arbupo/ESP32-Internet-Radio/schematics/Schéma 1.2.pdf

,rr:

### AO -:;;, -:r::oi r

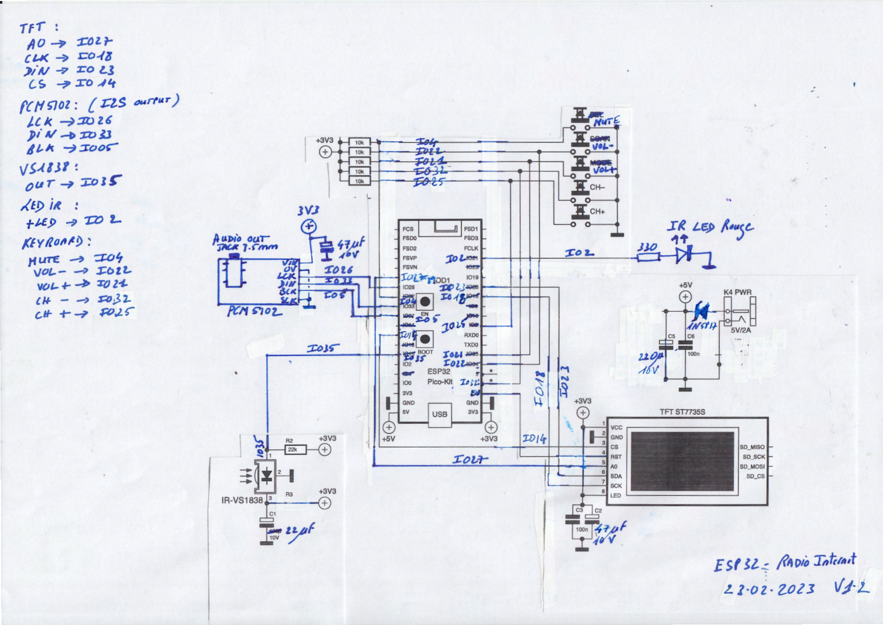
[picture p2: page 1]

CU< -> CO./Z ,,.A/ -7 XO l.l

### l~ .ro A't

f{ M Ç]Ol : { ~z.s ourfur)

J.t J< :IV Z 6
J/ A/ -1> :z:t>j)
41, I< ::roo~

### VSAIJ1:

ouT -::Colr
,<EJ> Ïll
tUJ> -Z::O L
KEY/lOlfl!>
tf uTE -=r:.o',
\JO/.. - -> j;O t Z..
VO 1.- +- X() Z-1-
l l+ - -> ~J,
e,H- +- | ~.}_$
. | L
JV.J

~ &li'"~
0 0--'-'-

.x. .,. f--
,....

'1/04
f--
CH-
Au1>10 o<Jr r,,ur7.nnm | :~~ol bd 1::~;r 1111 | - - | .J. | {~ t.1;.p '"jl-- Fso2 | FCLK | _. | ~JO
FSVP | ;ro l,.ttffl | >-0 Z..
- 1

# z.cH+

1"1001 1019

if Jj::~1 -+-1 +----41--+-1-1 1

:1,01-f-1 1

RXDO
::&oJ, | 11 | TXDO

# 1 't !f ,TT ~~~~ t-- ---1----'I 1

- ESP32
Pico-Kit

Il-.
c:i
\..\.

+3V3 1 'U) I ,,

,.,

l~

vcc

GND
CS
:COI.il- | 1¹ | .1 1 | 1 'I •I RST

,:. ttbf ...wiov

SDA
SCK
LED

T,'oo~ r,11f
~ ~vv

+SV

TFT ST7735S

SD

_

MISO
SD

_

SCK
SD

_

MOSI
SD

_

CS

## ESf ~l .::: /?APIO 1i,li1A,t

L. 1 ·0 Z · ZOl :J V,l· L
