arbupo/ESP32-Internet-Radio/schematics/Schéma.pdf

## rrr:

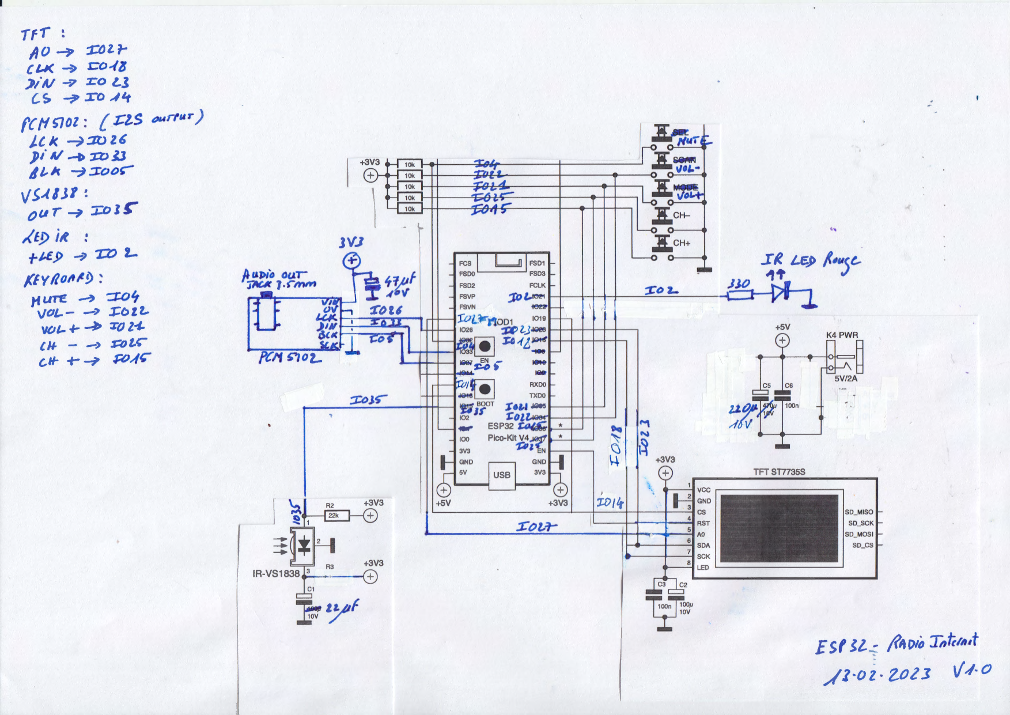
[picture p3: page 1]

### A o _,. -:r::o z. r

c U<. -> ro.,fi
;>iA/ -7 ro l.l
l> -:;, .ro A"t
f( f( ',]OZ : { ~Z.S ""'rfur) J.tJ<.
pi A/ -1> :rt> .il
41,1< 7 ::rooç-
VSA I JI:
ouT Iol r
,<EJ;> ilf :
t-UJ> -J -W 2-
KEY/lolfl!)
tf uTE -:::r:c',
vot..- -> ,1;otz ..
VCJ l- +- I() l-1-
l l+ - -> ~z.ç
e,ir +-~ ~Aç

/+.&&1>10 our
1ltUt1,f"mM

fCl'f S"IO

JV.J

1-

'r1f!f 1 ,IP'I/

CH-

## z.cH+

FCS I | lb....!] IFSD1
FSD0 | FSD3
FSD2 | FCLK
FSVP | .:f0 L,~ | :roz..
VN | 1er:!' | 1, '
=;:-51001 | 1019 if 11::1-11 l-+-1--+-I +-+I 1-+I-----,

RXDO

::t:t>J~ | ; 111 | 1 Wjj°T
1 | 102 | ESP32,

,:_,, ttbf

~OV

- Pico-Kit

°" ,...,

~ | '
CJ H \..+ | +3V3
1 | 1 | 1w,,,1 1 · 1 'j:;: :J:Olit- | 1 | . | RST +SV | +3V3

## Too~ooµ

~

.OV

# .It t..E.p ,,,,t,, 11'

+SV

TFTST7735S

SD_MISO
SD

_

SCK

SD_CS

### E Sf ~l.; ;?11010 r,,fi,,,,t

~]-OZ · ZOl 3 \/-1· 0
