arbupo/ESP32-Internet-Radio/images/221667.jpg

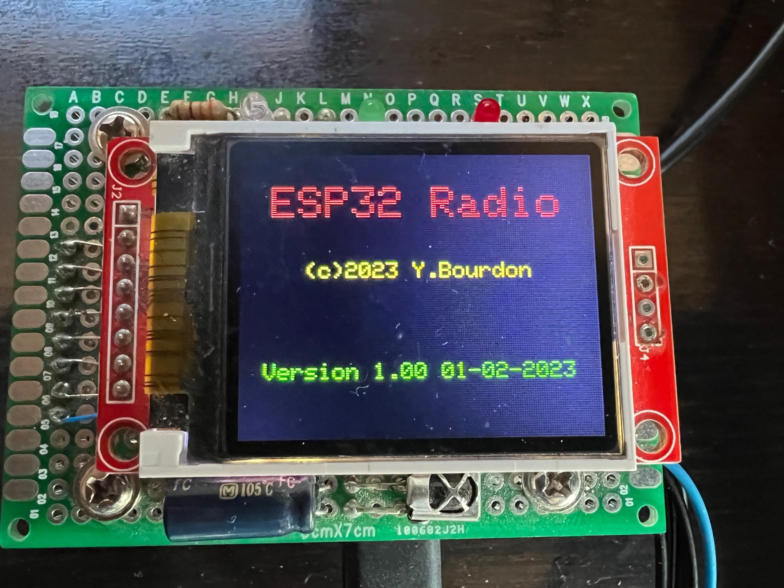
images/221667.jpg
