arbupo/ESP32-Internet-Radio/images/221671.jpg

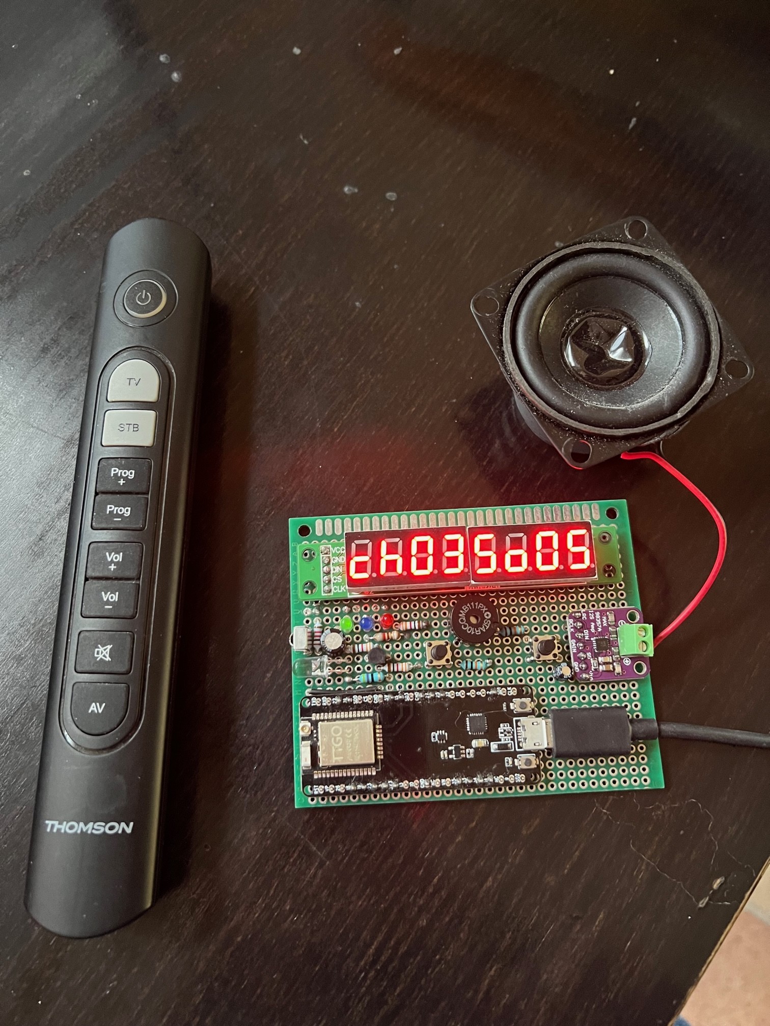
images/221671.jpg
