arbupo/ESP32-Internet-Radio/images/221672.jpg

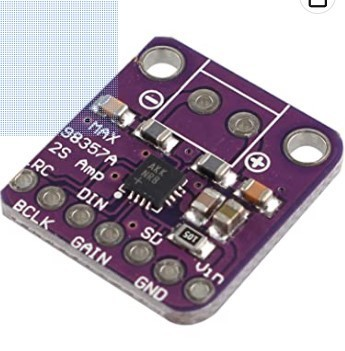
images/221672.jpg
