arbupo/ESP32-Internet-Radio/images/221673.jpg

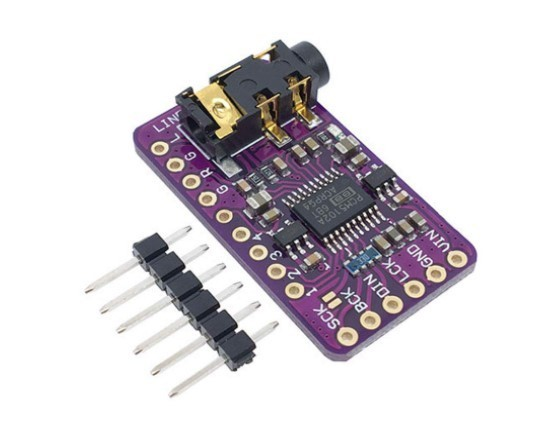
images/221673.jpg
