arbupo/ESP32-Internet-Radio/images/221978.jpg

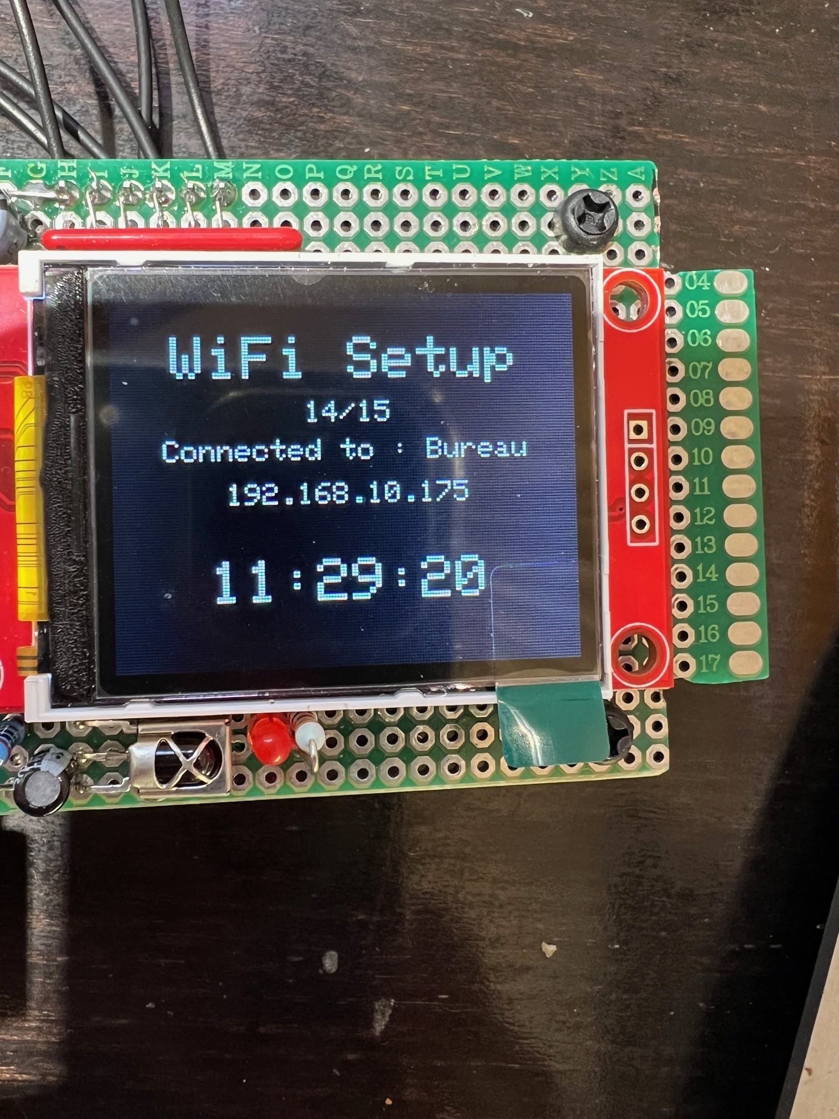
images/221978.jpg
