arbupo/ESP32-Internet-Radio/images/221979.jpg

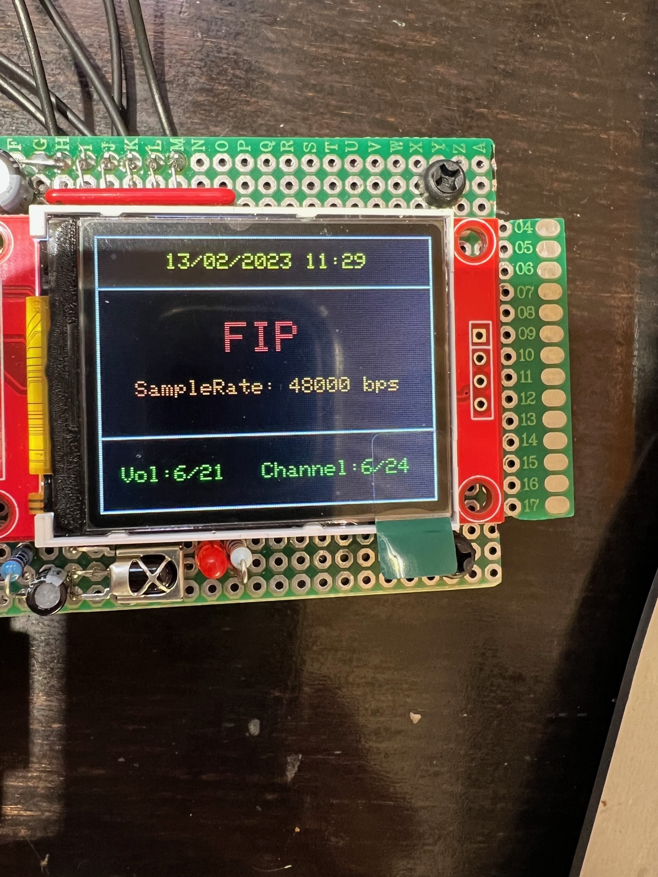
images/221979.jpg
