arbupo/ESP32-Internet-Radio/images/221980.jpg

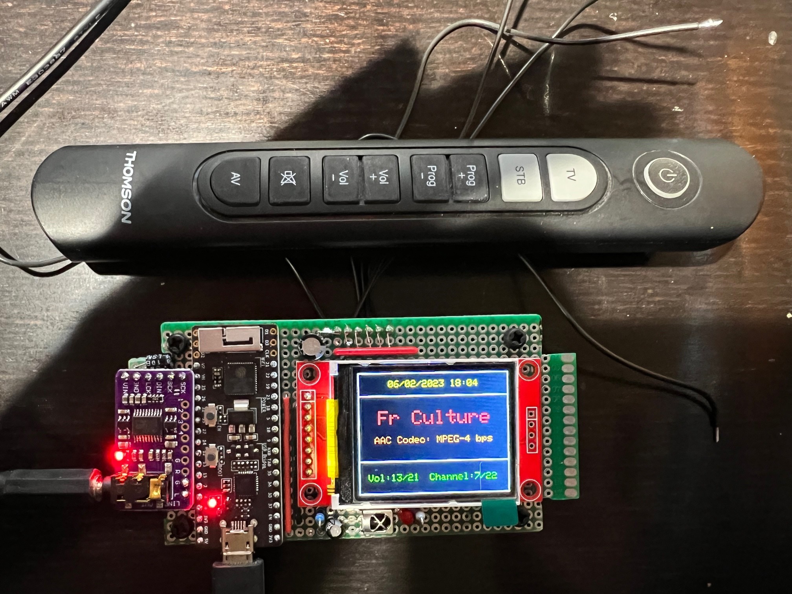
images/221980.jpg
