arbupo/ESP32-Internet-Radio/images/222188.jpg

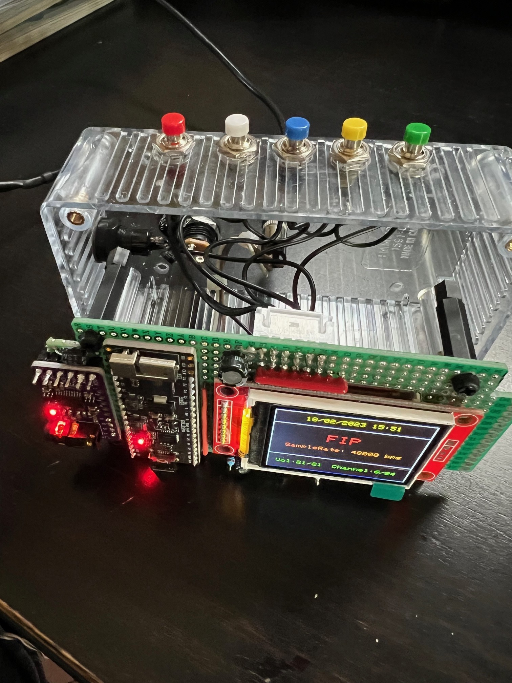
images/222188.jpg
