arbupo/ESP32-Internet-Radio/images/222189.jpg

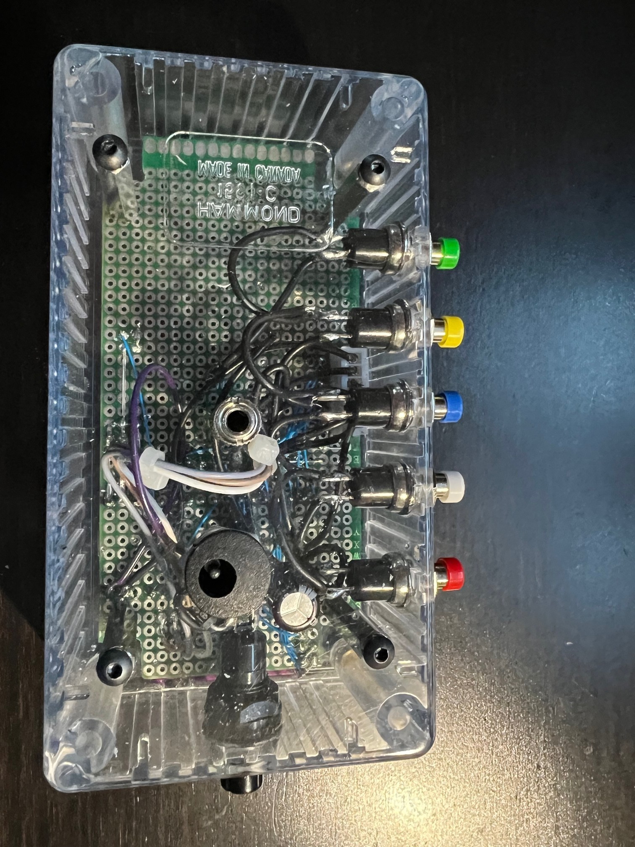
images/222189.jpg
