arbupo/ESP32-Internet-Radio/images/222190.jpg

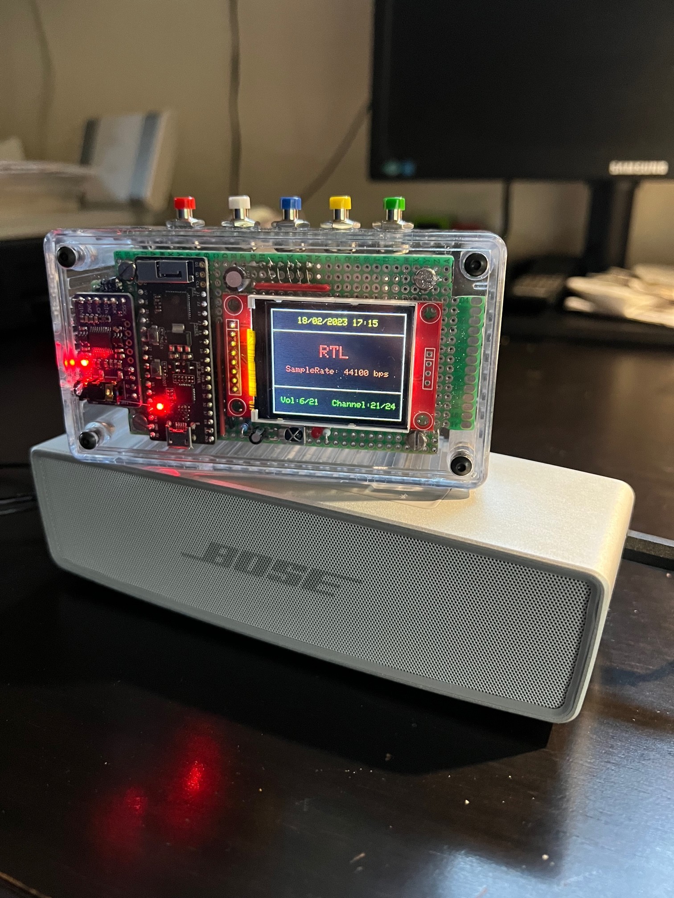
images/222190.jpg
