arbupo/ESP32-Internet-Radio/images/222570.jpg

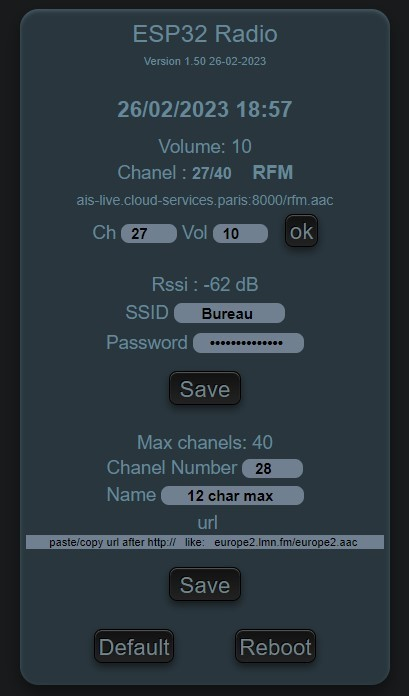
images/222570.jpg
