arbupo/ESP32-Internet-Radio/images/223124.jpg

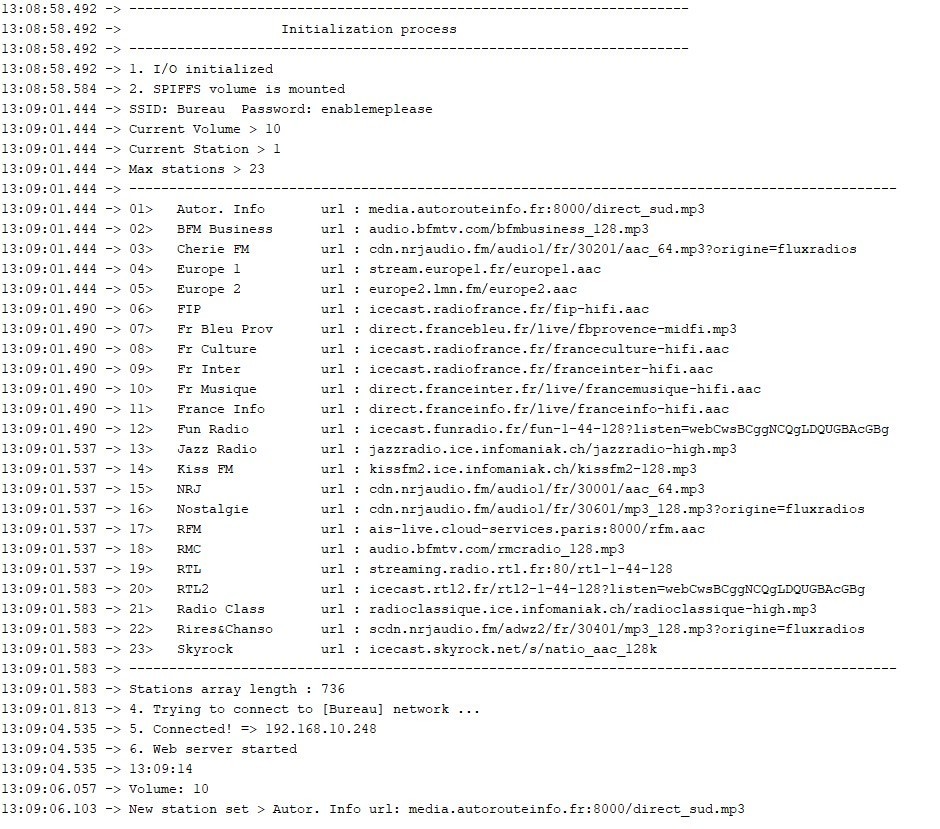
images/223124.jpg
