arbupo/ESP32-Internet-Radio/images/223325.png

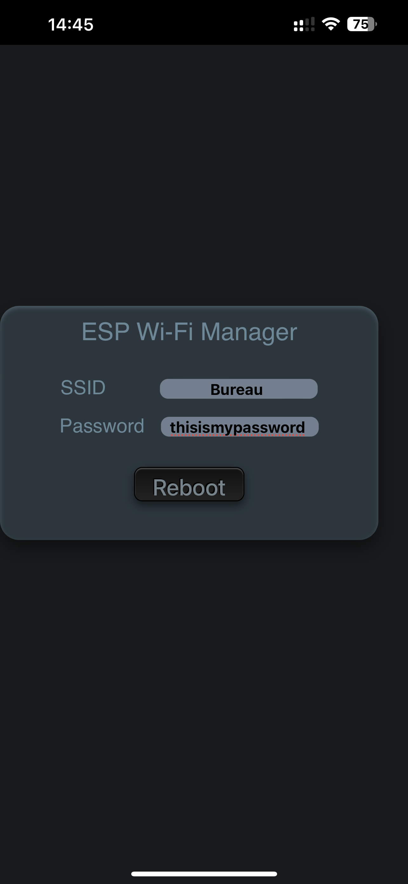
images/223325.png
