arbupo/ESP32-Internet-Radio/images/223326.jpg

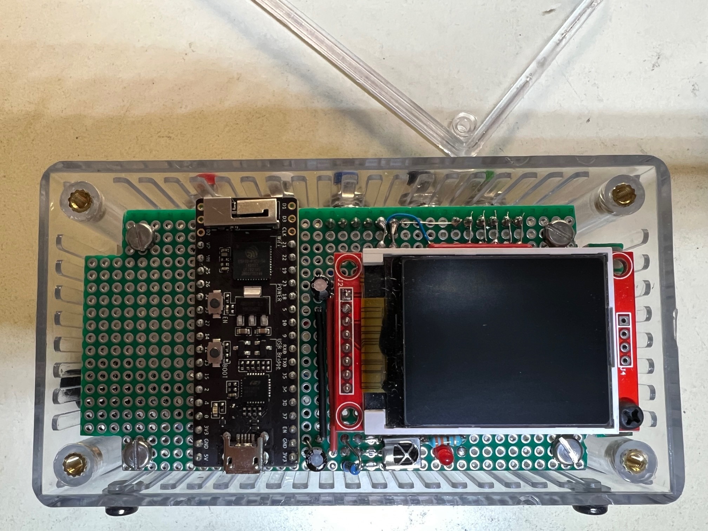
images/223326.jpg
