arbupo/ESP32-Internet-Radio/images/223327.jpg

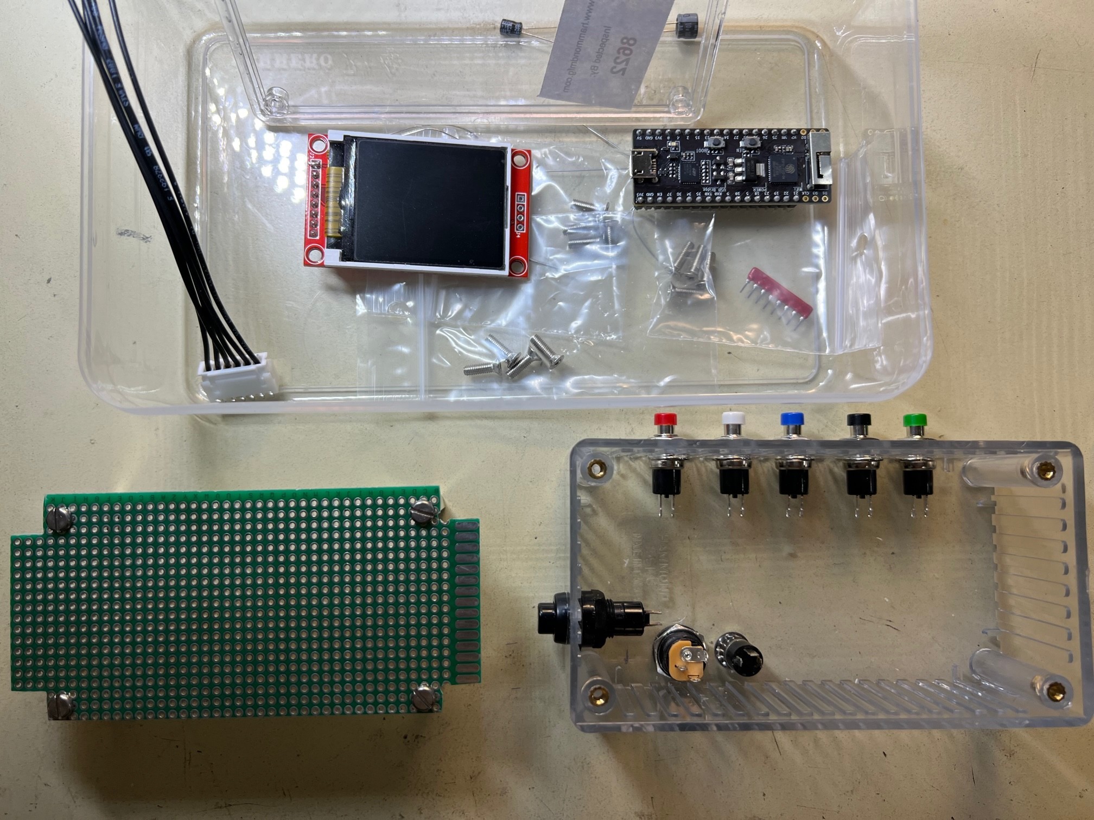
images/223327.jpg
