arbupo/ESP32-Internet-Radio/images/223328.jpg

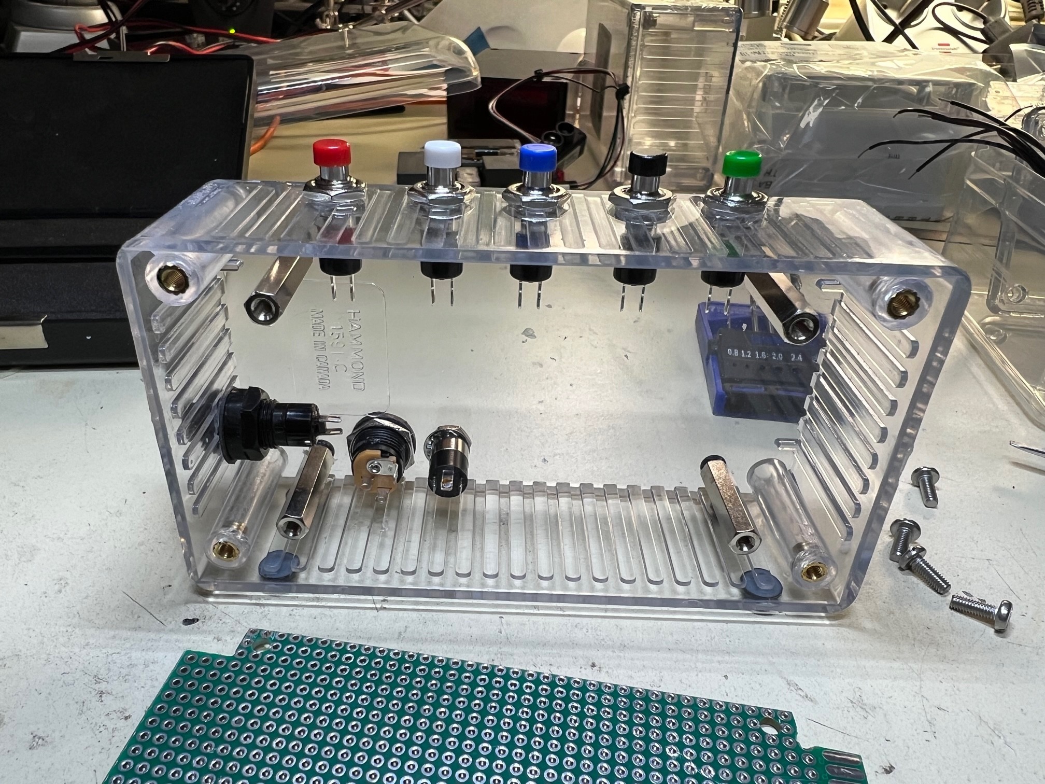
images/223328.jpg
