arbupo/ESP32-Internet-Radio/images/223329.jpg

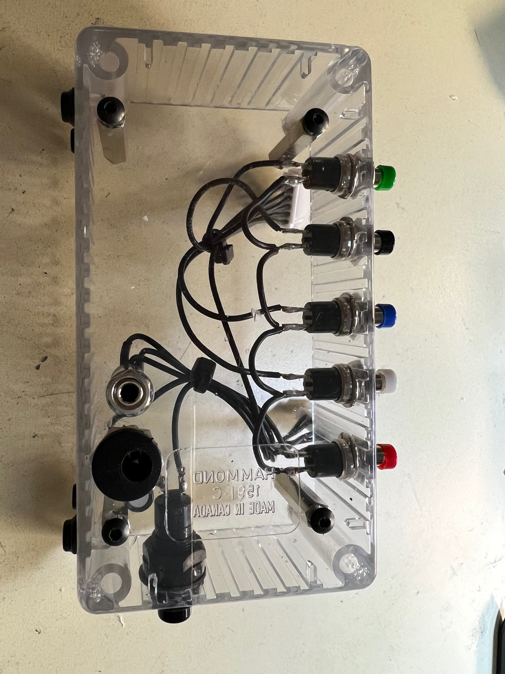
images/223329.jpg
