arbupo/ESP32-Internet-Radio/images/223330.jpg

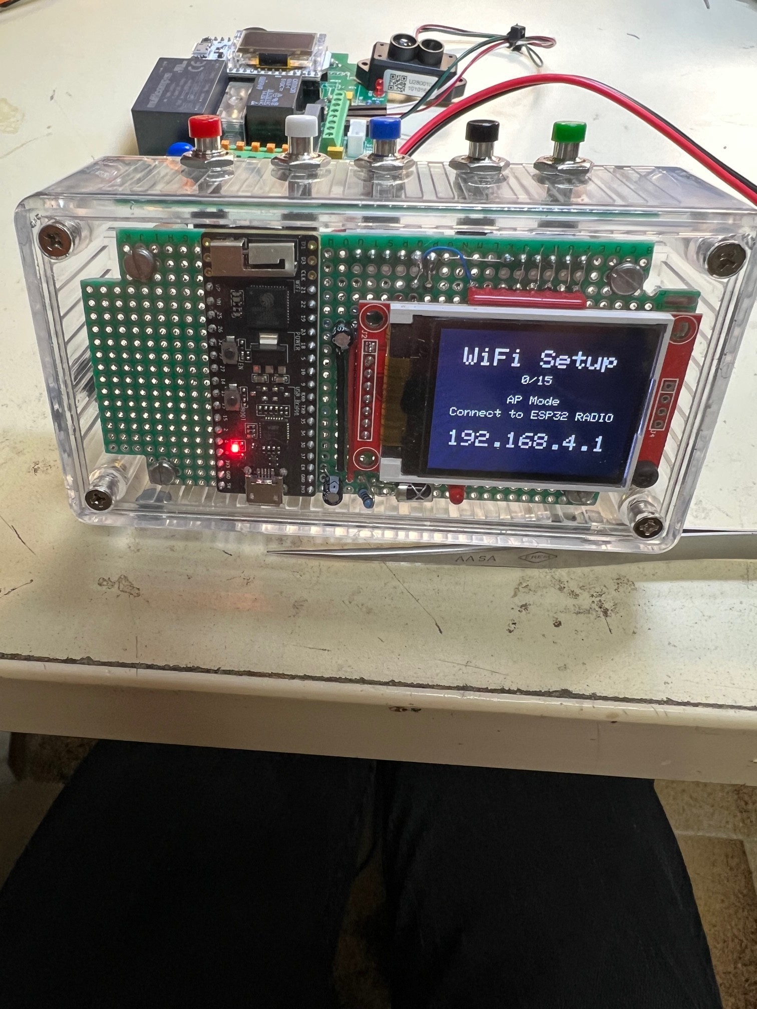
images/223330.jpg
