arbupo/ESP32-Internet-Radio/images/223331.jpg

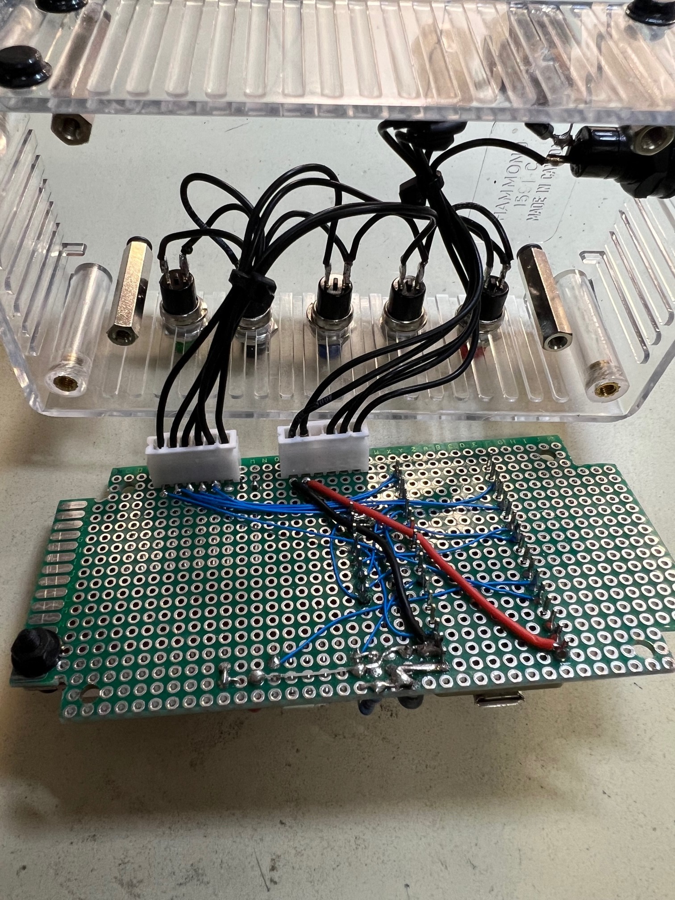
images/223331.jpg
