arbupo/ESP32-Internet-Radio/images/223976.jpg

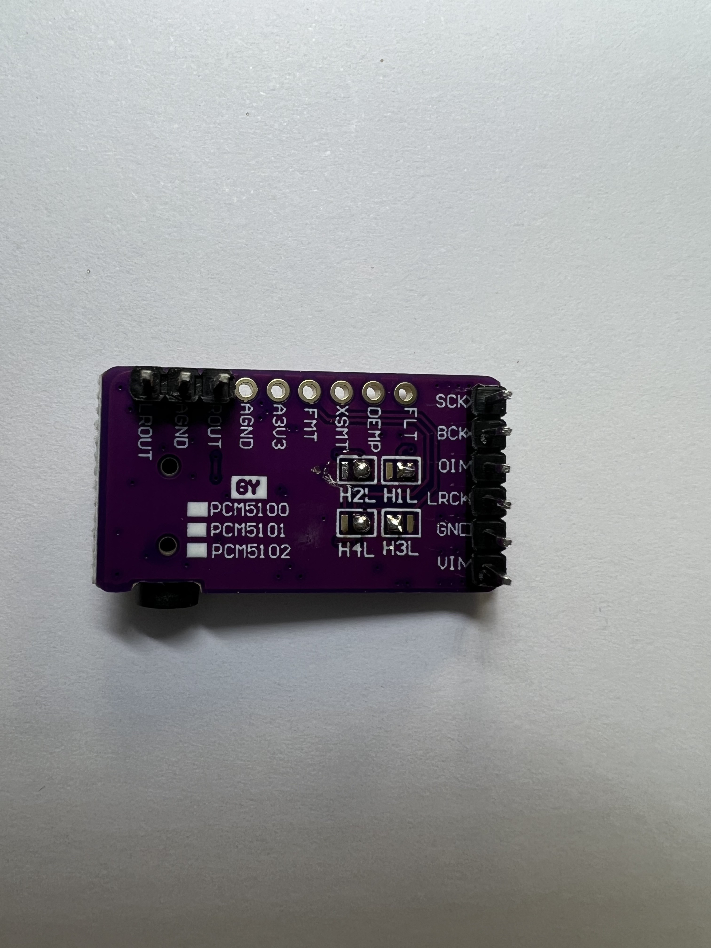
images/223976.jpg
