arbupo/ESP32-Internet-Radio/images/224061.jpg

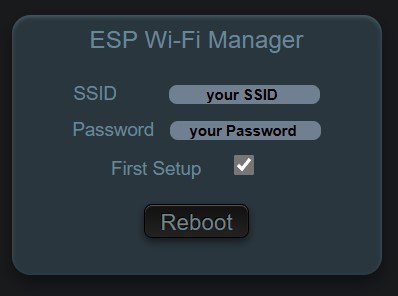
images/224061.jpg
