arbupo/ESP32-Internet-Radio/(commit log)

2026-01-17 feat: add schematics
2026-01-17 feat: uncompress ESP32_Radio_I2S 1.71
2026-01-17 fix: fix AsyncWebParameter adding const
    [init.ino]
2026-01-18 fix: initialize spi for display
    [ESP32_Radio_I2S.ino]
2026-01-18 feat: turn led off when init
2026-01-18 feat: update ports for esp32-s3
2026-01-18 fix: Normalize line endings
    [ESP32_Radio_I2S.ino, init.ino, preferences.ino, screen.ino, webserver.ino]
